RKinosaki/Odyssey/Drive/PCB/Odyssey_Driver.step

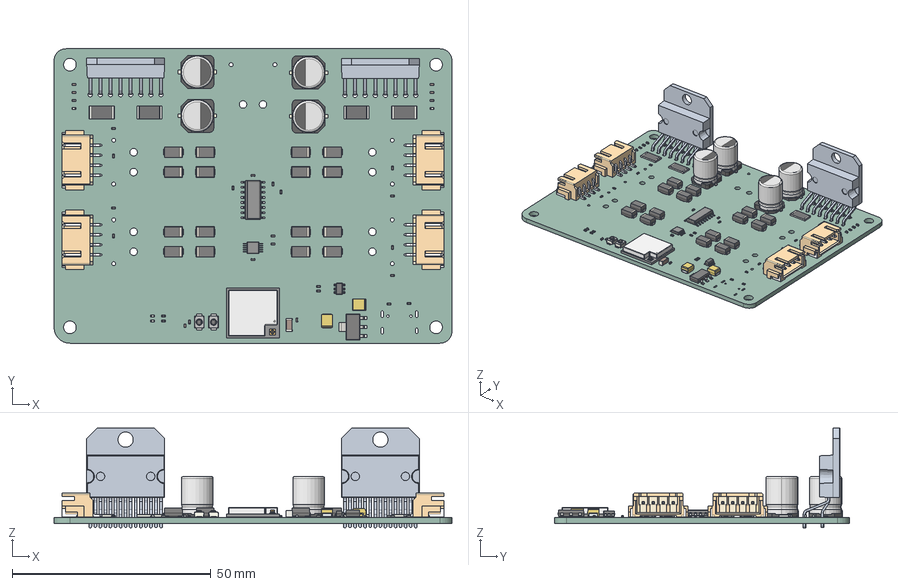
[picture p1: CAD file, 2026-05-25]
Drive/PCB/Odyssey_Driver.step
100.0 x 74.0 x 25.1 mm
R_0402_1005Metric x 22
D_SMA x 16
WSIZE CODE F-001 x 4
WSIZE CODE F-002 x 4
WSIZE CODE F-003 x 8
C_0402_1005Metric x 8
R_2512_6332Metric x 4
ESP32-C6-MINI-1U-N4
SOT-23-6
S4B-XH-SM4-TB_LF__SN_ x 4
LED_0402_1005Metric x 4
FilletPin1 x 2
FilletPin2 x 2
L298N x 2
SW_SPST_B3U-1000P x 2
C_1206_3216Metric
BODY-SO x 2
LEAD-SO x 26
PIN1-ID x 2
SOT-223
Odyssey_Driver_PCB
