RKinosaki/Odyssey/PowerDistribution/PCB/LabRover_PDB.kicad_pcb

## KiCad design PowerDistribution/PCB/LabRover_PDB.kicad_pcb (2026-07-19)

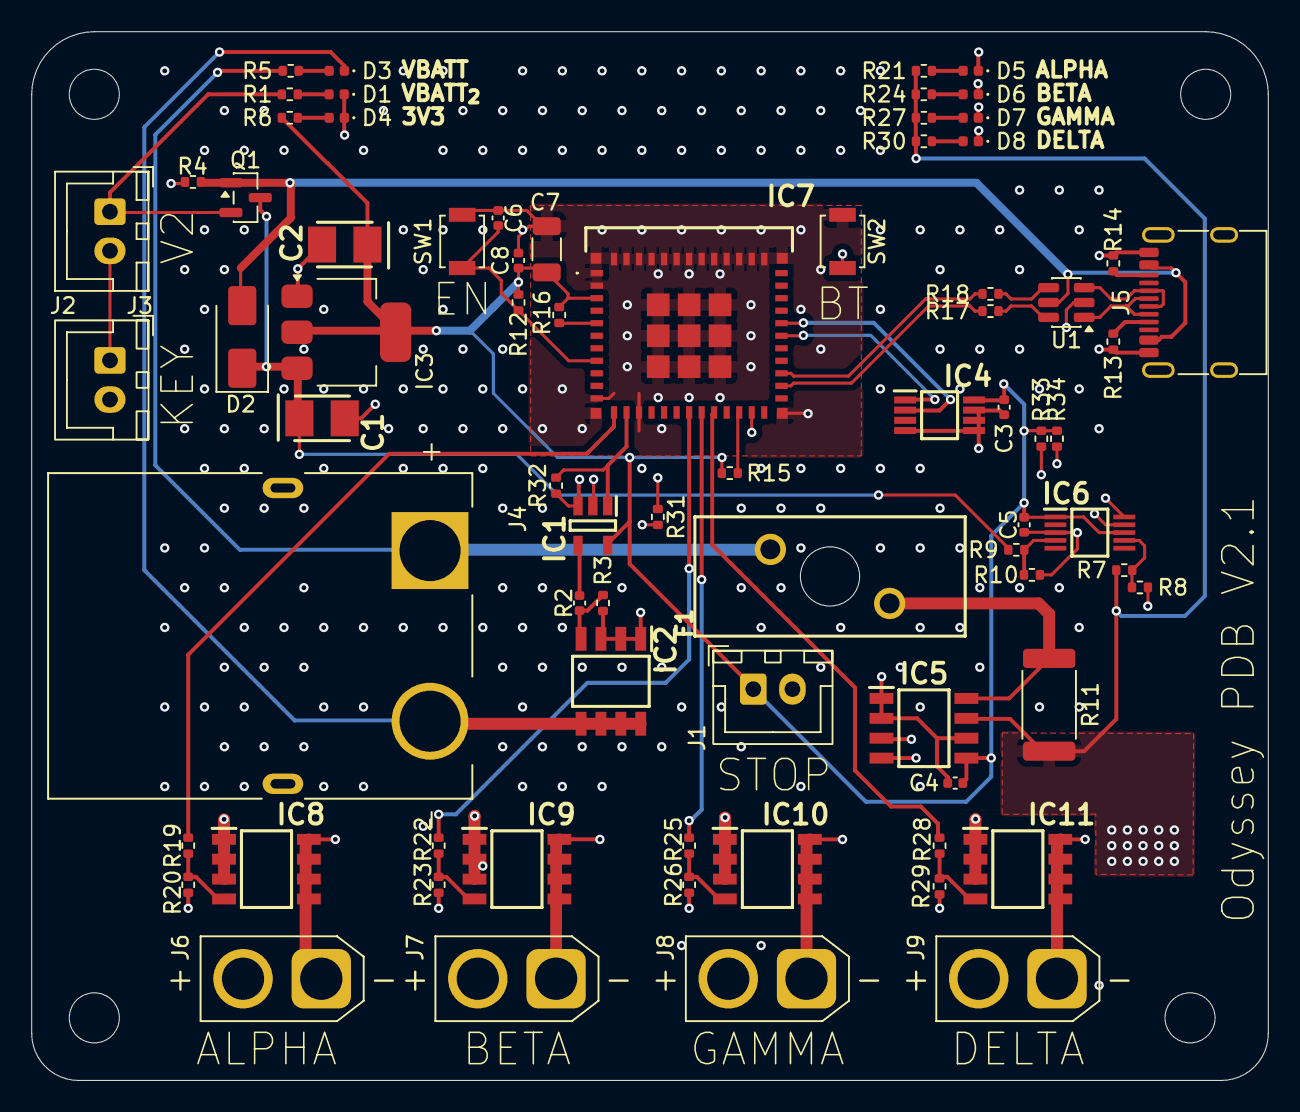
[picture p2: board LabRover_PDB.kicad_pcb from above]

Board: 4 copper layers, 79.0 x 67.0 mm, 75 parts (0 on the bottom side), 49 nets.

Parts:
C1, C2: TAJB226K020RNJ
C3, C4, C8: 100n; C_0402_1005Metric
C5, C6: 1u; C_0402_1005Metric
C7: 22u; C_1206_3216Metric
D1, D3, D4: GREEN; LED_0402_1005Metric
D2: SS12; D_SMA
D5, D6, D7, D8: BLUE; LED_0402_1005Metric
F1: 01530008Z; 01530008
IC1: SN74LVC1G08DBVR
IC2, IC8, IC9, IC10, IC11: SI4162DY-T1-GE3
IC3: TLV1117LV33DCYR; SOT-223-3_TabPin2
IC4: LM75BDP,118
IC5: INA219AIDR
IC6: ADS1015BQDGSRQ1
IC7: ESP32-C3-MINI-1U-N4X; ESP32C3MINI1UN4X
J1, J2, J3: Conn_01x02; JST_XH_B2B-XH-A_1x02_P2.50mm_Vertical
J4: Conn_01x02; AMASS_XT90PW-M
J5: USB_C_Receptacle_USB2.0_16P; USB_C_Receptacle_G-Switch_GT-USB-7010ASV
J6, J7, J8, J9: Conn_01x02; XT30
Q1: BSS84; SOT-23
R1: 1kR; R_0402_1005Metric
R2: 100; C_0402_1005Metric
R3, R10, R12, R15, R16, R20, R23, R26, R29, R31, R32, R33, R34: 10k; R_0402_1005Metric
R4: 10kR; R_0402_1005Metric
R5: 2.4k; R_0402_1005Metric
R6: 600; R_0402_1005Metric
R7: 560k; R_0402_1005Metric
R8: 100k; R_0402_1005Metric
R9: 5.1k; R_0402_1005Metric
R11: 0.01; R_2512_6332Metric
R13, R14: 5K1; R_0402_1005Metric
R17, R18: 22; R_0402_1005Metric
R19, R22, R25, R28: 100; R_0402_1005Metric
R21, R24, R27, R30: 470; R_0402_1005Metric
SW1, SW2: SW_Push; SW_SPST_B3U-1000P
U1: USBLC6-2SC6; SOT-23-6

Connections:
+3.3V: C2.1 (+), C3.1, C4.1, C5.1, C7.1, C8.1, IC1.5 (VCC), IC3.2 (OUTPUT_1), IC4.8 (VCC), IC5.5 (VS), IC6.1 (ADDR), IC6.8 (VDD), IC7.3 (3V3), J1.1, R6.2, R12.2, R15.1, R16.1, R33.1, R34.1
+BATT_SENSED: IC5.7 (IN-), J6.2, J7.2, J8.2, J9.2, R7.1, R11.2, R21.2, R24.2, R27.2, R30.2
+VBATT_{2}: J3.1, Q1.2 (S), R1.2
/ESP32_C3/5V: D2.2 (A), J5.A4 (VBUS), J5.A9 (VBUS), J5.B4 (VBUS), J5.B9 (VBUS), Q1.1 (G), R4.2, U1.5 (VBUS)
/ESP32_C3/BOOT: IC7.23 (IO9), SW2.1
/ESP32_C3/D+: R18.2, U1.4 (I/O2)
/ESP32_C3/D-: R17.2, U1.6 (I/O1)
/ESP32_C3/DR+: IC7.27 (IO19), R18.1
/ESP32_C3/DR-: IC7.26 (IO18), R17.1
/ESP32_C3/GPIO0: IC7.12 (IO0), R19.2
/ESP32_C3/GPIO1: IC1.1 (A), IC7.13 (IO1), R32.2
/ESP32_C3/GPIO2: IC7.5 (IO2), R16.2
/ESP32_C3/GPIO4: IC7.18 (IO4), R22.2
/ESP32_C3/GPIO5: IC7.19 (IO5), R25.2
/ESP32_C3/GPIO6: IC7.20 (IO6), R28.2
/ESP32_C3/GPIO8: IC7.22 (IO8), R15.2
/ESP32_C3/GPIO20: IC4.1 (SDA), IC5.3 (SDA), IC6.9 (SDA), IC7.30 (RXD0), R33.2
/ESP32_C3/GPIO21: IC4.2 (SCL), IC5.4 (SCL), IC6.10 (SCL), IC7.31 (TXD0), R34.2
/ESP32_C3/RST: C6.1, IC7.8 (EN), R12.1, SW1.1
/ESP32_C3/USB_D+: J5.A6 (D+), J5.B6 (D+), U1.3 (I/O2)
/ESP32_C3/USB_D-: J5.A7 (D-), J5.B7 (D-), U1.1 (I/O1)
/Power_Protection/VBATT_{2}Read: C1.1 (+), D2.1 (K), IC3.3 (INPUT), Q1.3 (D), R9.1
/Sensors/AIN0: IC6.4 (AIN0), R9.2, R10.1
/Sensors/AIN3: IC6.7 (AIN3), R7.2, R8.1
/Sensors/IN+: F1.2, IC5.8 (IN+), R11.1
GND: C1.2 (-), C2.2 (-), C3.2, C4.2, C5.2, C6.2, C7.2, C8.2, D1.1 (K), D4.1 (K), IC1.3 (GND), IC2.1 (S_1), IC2.2 (S_2), IC2.3 (S_3), IC3.1 (GND), IC4.4 (GND), IC4.5 (A2), IC4.6 (A1), IC4.7 (A0), IC5.1 (A1), IC5.2 (A0), IC5.6 (GND), IC6.3 (GND), IC7.1 (GND_1), IC7.2 (GND_2), IC7.11 (GND_3), IC7.14 (GND_4), IC7.36 (GND_5), IC7.37 (GND_6), IC7.38 (GND_7), IC7.39 (GND_8), IC7.40 (GND_9), IC7.41 (GND_10), IC7.42 (GND_11), IC7.43 (GND_12), IC7.44 (GND_13), IC7.45 (GND_14), IC7.46 (GND_15), IC7.47 (GND_16), IC7.48 (GND_17), IC7.49 (GND_18), IC7.50 (GND_19), IC7.51 (GND_20), IC7.52 (GND_21), IC7.53 (GND_22), IC7.54 (GND_23), IC7.55 (GND_24), IC7.56 (GND_25), IC7.57 (GND_26), IC7.58 (GND_27), IC7.59 (GND_28), IC7.60 (GND_29), IC7.61 (GND_30), IC8.1 (S_1), IC8.2 (S_2), IC8.3 (S_3), IC9.1 (S_1), IC9.2 (S_2), IC9.3 (S_3), IC10.1 (S_1), IC10.2 (S_2), IC10.3 (S_3), IC11.1 (S_1), IC11.2 (S_2), IC11.3 (S_3), J2.2, J5.A1 (GND), J5.A12 (GND), J5.B1 (GND), J5.B12 (GND), R3.1, R4.1, R8.2, R10.2, R13.2, R14.1, R20.1, R23.1, R26.1, R29.1, R31.1, R32.1, SW1.2, SW2.2, U1.2 (GND)
unnamed: D1.2 (A), R1.1
unnamed: D3.2 (A), R5.1
unnamed: D3.1 (K), IC2.5 (D_1), IC2.6 (D_2), IC2.7 (D_3), IC2.8 (D_4)
unnamed: D4.2 (A), R6.1
unnamed: D5.2 (A), R21.1
unnamed: D5.1 (K), IC8.5 (D_1), IC8.6 (D_2), IC8.7 (D_3), IC8.8 (D_4), J6.1
unnamed: D6.2 (A), R24.1
unnamed: D6.1 (K), IC9.5 (D_1), IC9.6 (D_2), IC9.7 (D_3), IC9.8 (D_4), J7.1
unnamed: D7.2 (A), R27.1
unnamed: D7.1 (K), IC10.5 (D_1), IC10.6 (D_2), IC10.7 (D_3), IC10.8 (D_4), J8.1
unnamed: D8.2 (A), R30.1
unnamed: D8.1 (K), IC11.5 (D_1), IC11.6 (D_2), IC11.7 (D_3), IC11.8 (D_4), J9.1
unnamed: IC1.2 (B), J1.2, R31.2
unnamed: IC1.4 (Y), R2.1
unnamed: IC2.4 (G), R2.2, R3.2
unnamed: IC8.4 (G), R19.1, R20.2
unnamed: IC9.4 (G), R22.1, R23.2
unnamed: IC10.4 (G), R25.1, R26.2
unnamed: IC11.4 (G), R28.1, R29.2
unnamed: J2.1, J3.2
unnamed: F1.1, R5.2
unnamed: J5.A5 (CC1), R13.1
unnamed: J5.B5 (CC2), R14.2
