RKinosaki/Odyssey/Drive/PCB/Odyssey_Driver.kicad_pcb

## KiCad design Drive/PCB/Odyssey_Driver.kicad_pcb (2026-05-03)

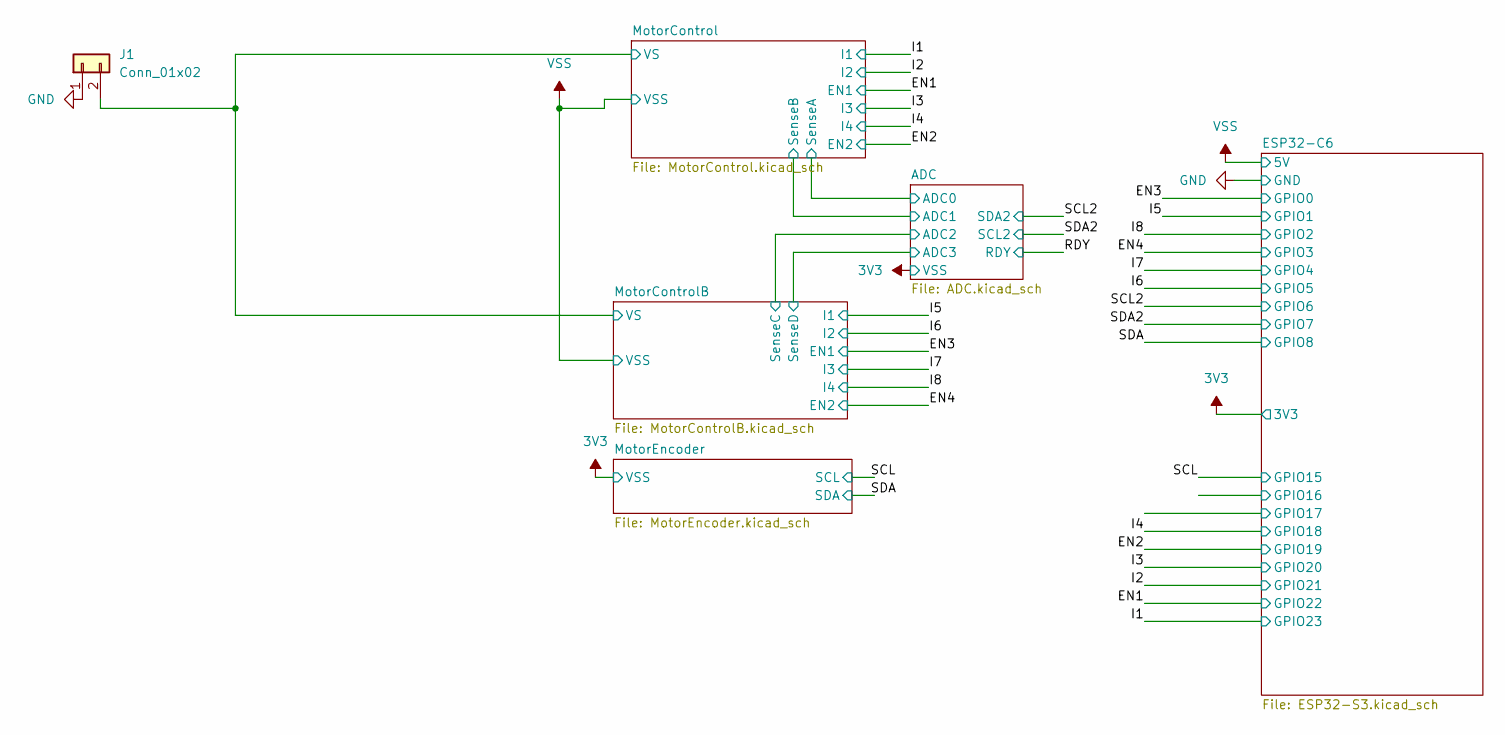
[picture p3: schematic Odyssey_Driver.kicad_sch]

Parts:
J1: Conn_01x02; AMASS_XT30PW-M_1x02_P2.50mm_Horizontal

Connections:
/MotorControl/VS: J1.2; also elsewhere on the board
GND: J1.1; also elsewhere on the board

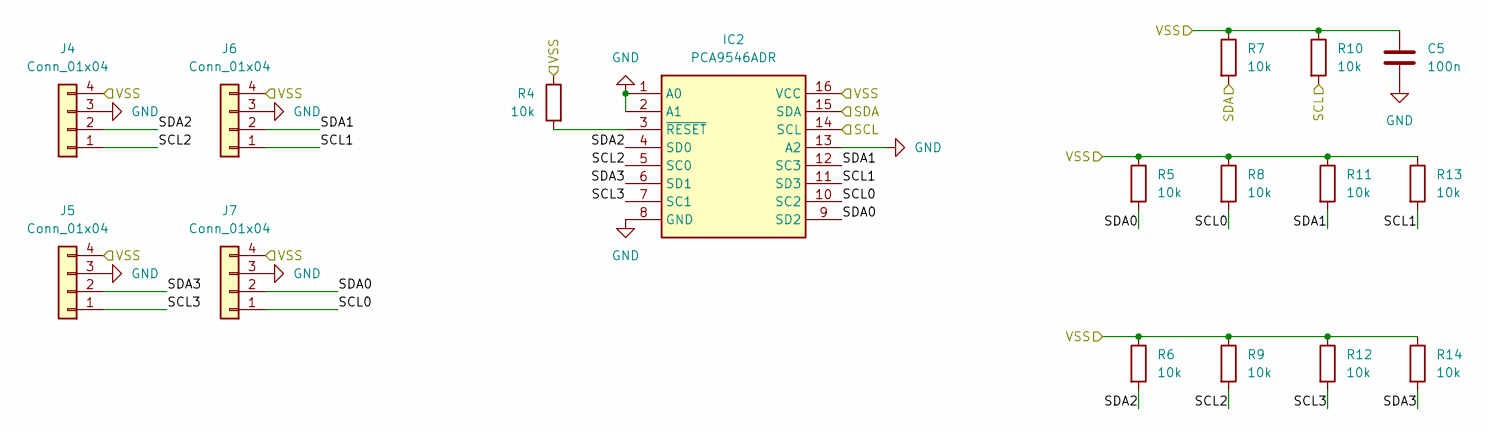
[picture p4: schematic MotorEncoder.kicad_sch]

Parts:
C5: 100n; C_0402_1005Metric
IC2: PCA9546ADR; SOIC127P600X175-16N; Mouser Part Number 595-PCA9546ADR
J4, J5, J6, J7: Conn_01x04; S4BXHSM4TBLFSN
R4, R5, R6, R7, R8, R9, R10, R11, R12, R13, R14: 10k; R_0402_1005Metric

Connections:
3V3: C5.1, IC2.16 (VCC), J4.4, J5.4, J6.4, J7.4, R4.1, R5.1, R6.1, R7.1, R8.1, R9.1, R10.1, R11.1, R12.1, R13.1, R14.1; also elsewhere on the board
/MotorEncoder/SCL0: IC2.10 (SC2), J7.1, R8.2
/MotorEncoder/SCL1: IC2.11 (SD3), J6.1, R13.2
/MotorEncoder/SCL2: IC2.5 (SC0), J4.1, R9.2
/MotorEncoder/SCL3: IC2.7 (SC1), J5.1, R12.2
/MotorEncoder/SDA0: IC2.9 (SD2), J7.2, R5.2
/MotorEncoder/SDA1: IC2.12 (SC3), J6.2, R11.2
/MotorEncoder/SDA2: IC2.4 (SD0), J4.2, R6.2
/MotorEncoder/SDA3: IC2.6 (SD1), J5.2, R14.2
/SCL: IC2.14 (SCL), R10.2; also elsewhere on the board
/SDA: IC2.15 (SDA), R7.2; also elsewhere on the board
GND: C5.2, IC2.1 (A0), IC2.2 (A1), IC2.8 (GND), IC2.13 (A2), J4.3, J5.3, J6.3, J7.3; also elsewhere on the board
unnamed: IC2.3 (~RESET), R4.2

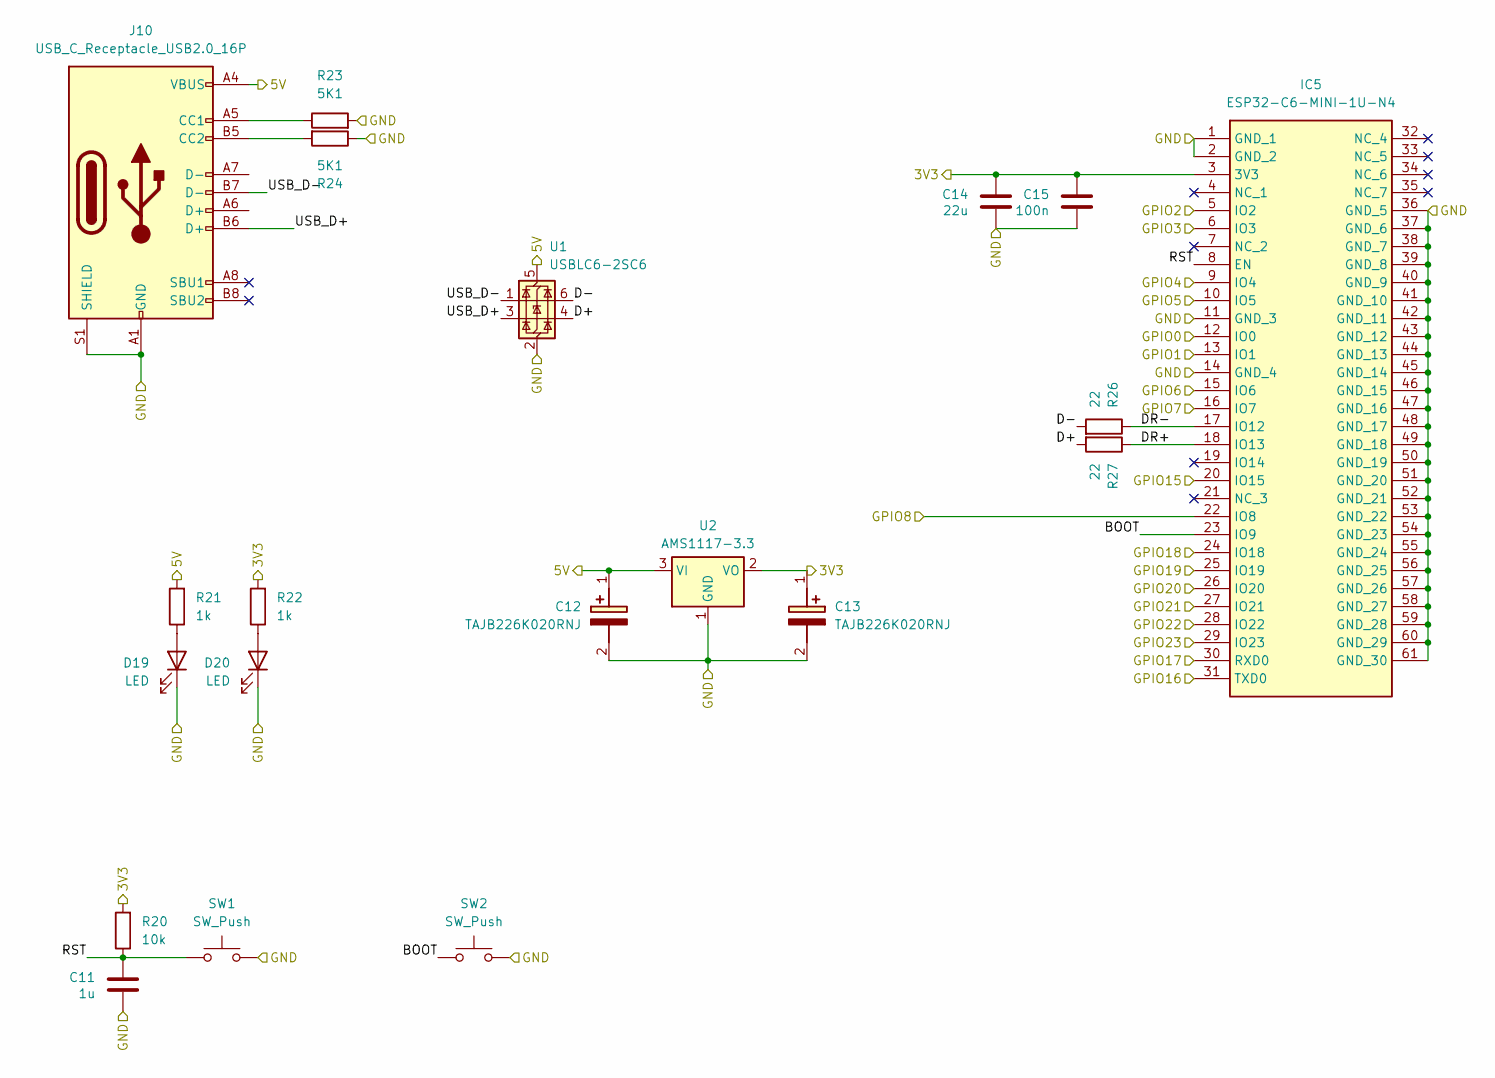
[picture p5: schematic ESP32-S3.kicad_sch]

Parts:
C11: 1u; C_0402_1005Metric
C12, C13: TAJB226K020RNJ; CAPPM3528X210N; Mouser Part Number 581-TAJB226K020R
C14: 22u; C_1206_3216Metric
C15: 100n; C_0402_1005Metric
D19, D20: LED; LED_0402_1005Metric
IC5: ESP32-C6-MINI-1U-N4; ESP32C6MINI1UN4; Mouser Part Number 356-ESP32-C6MINI1UN4
J10: USB_C_Receptacle_USB2.0_16P; USB_C_Receptacle_G-Switch_GT-USB-7010ASV
R20: 10k; R_0402_1005Metric
R21, R22: 1k; R_0402_1005Metric
R23, R24: 5K1; R_0402_1005Metric
R26, R27: 22; R_0402_1005Metric
SW1, SW2: SW_Push; SW_SPST_B3U-1000P
U1: USBLC6-2SC6; SOT-23-6
U2: AMS1117-3.3; SOT-223-3_TabPin2

Connections:
3V3: C13.1 (+), C14.1, C15.1, IC5.3 (3V3), R20.2, R22.2, U2.2 (VO); also elsewhere on the board
/EN1: IC5.28 (IO22); also elsewhere on the board
/EN2: IC5.25 (IO19); also elsewhere on the board
/EN3: IC5.12 (IO0); also elsewhere on the board
/EN4: IC5.6 (IO3); also elsewhere on the board
/ESP32-C6/BOOT: IC5.23 (IO9), SW2.1
/ESP32-C6/D+: R27.2, U1.4 (I/O2)
/ESP32-C6/D-: R26.2, U1.6 (I/O1)
/ESP32-C6/DR+: IC5.18 (IO13), R27.1
/ESP32-C6/DR-: IC5.17 (IO12), R26.1
/ESP32-C6/GPIO16: IC5.31 (TXD0)
/ESP32-C6/GPIO17: IC5.30 (RXD0)
/ESP32-C6/RST: C11.1, IC5.8 (EN), R20.1, SW1.1
/ESP32-C6/USB_D+: J10.B6 (D+), U1.3 (I/O2)
/ESP32-C6/USB_D-: J10.B7 (D-), U1.1 (I/O1)
/I1: IC5.29 (IO23); also elsewhere on the board
/I2: IC5.27 (IO21); also elsewhere on the board
/I3: IC5.26 (IO20); also elsewhere on the board
/I4: IC5.24 (IO18); also elsewhere on the board
/I5: IC5.13 (IO1); also elsewhere on the board
/I6: IC5.10 (IO5); also elsewhere on the board
/I7: IC5.9 (IO4); also elsewhere on the board
/I8: IC5.5 (IO2); also elsewhere on the board
/SCL: IC5.20 (IO15); also elsewhere on the board
/SCL2: IC5.15 (IO6); also elsewhere on the board
/SDA: IC5.22 (IO8); also elsewhere on the board
/SDA2: IC5.16 (IO7); also elsewhere on the board
GND: C11.2, C12.2 (-), C13.2 (-), C14.2, C15.2, D19.1 (K), D20.1 (K), IC5.1 (GND_1), IC5.2 (GND_2), IC5.11 (GND_3), IC5.14 (GND_4), IC5.36 (GND_5), IC5.37 (GND_6), IC5.38 (GND_7), IC5.39 (GND_8), IC5.40 (GND_9), IC5.41 (GND_10), IC5.42 (GND_11), IC5.43 (GND_12), IC5.44 (GND_13), IC5.45 (GND_14), IC5.46 (GND_15), IC5.47 (GND_16), IC5.48 (GND_17), IC5.49 (GND_18), IC5.50 (GND_19), IC5.51 (GND_20), IC5.52 (GND_21), IC5.53 (GND_22), IC5.54 (GND_23), IC5.55 (GND_24), IC5.56 (GND_25), IC5.57 (GND_26), IC5.58 (GND_27), IC5.59 (GND_28), IC5.60 (GND_29), IC5.61 (GND_30), J10.A1 (GND), J10.A12 (GND), J10.B1 (GND), J10.B12 (GND), J10.S1 (SHIELD), R23.2, R24.1, SW1.2, SW2.2, U1.2 (GND), U2.1 (GND); also elsewhere on the board
unnamed: D19.2 (A), R21.1
unnamed: D20.2 (A), R22.1
unnamed: J10.A5 (CC1), R23.1
unnamed: J10.B5 (CC2), R24.2
VSS: C12.1 (+), J10.A4 (VBUS), J10.A9 (VBUS), J10.B4 (VBUS), J10.B9 (VBUS), R21.2, U1.5 (VBUS), U2.3 (VI); also elsewhere on the board

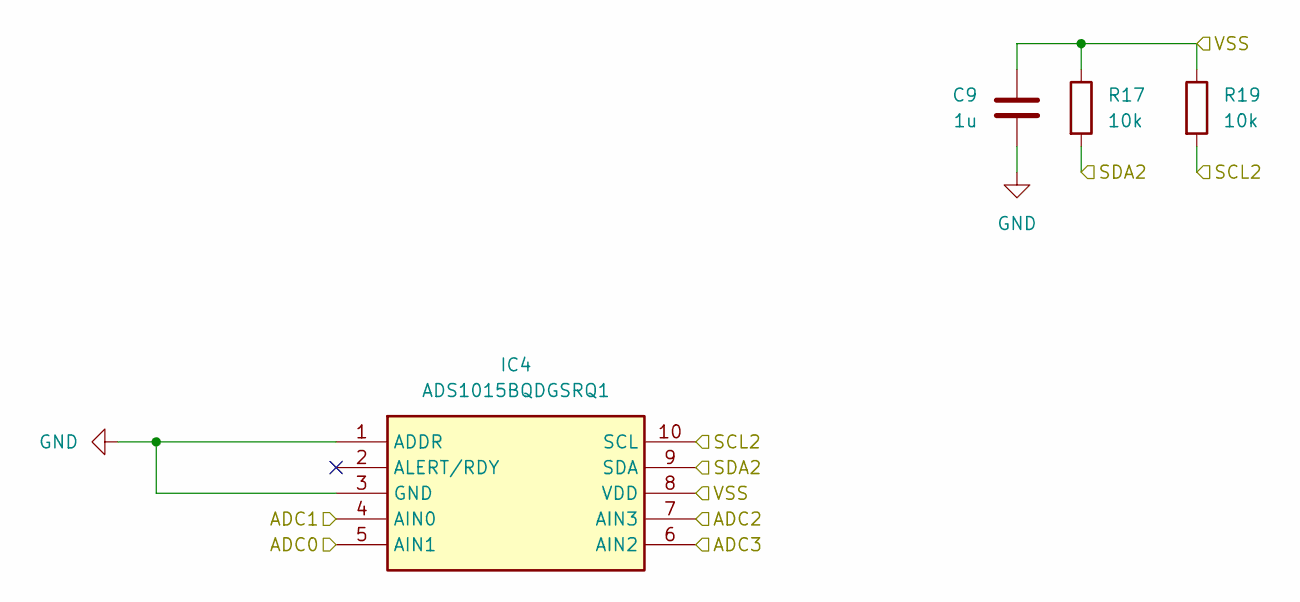
[picture p6: schematic ADC.kicad_sch]

Parts:
C9: 1u; C_0402_1005Metric
IC4: ADS1015BQDGSRQ1; SOP50P490X110-10N; Mouser Part Number 595-ADS1015BQDGSRQ1
R17, R19: 10k; R_0402_1005Metric

Connections:
3V3: C9.1, IC4.8 (VDD), R17.1, R19.1; also elsewhere on the board
/ADC/ADC0: IC4.5 (AIN1); also elsewhere on the board
/ADC/ADC1: IC4.4 (AIN0); also elsewhere on the board
/ADC/ADC2: IC4.7 (AIN3); also elsewhere on the board
/ADC/ADC3: IC4.6 (AIN2); also elsewhere on the board
/SCL2: IC4.9 (SDA), R17.2; also elsewhere on the board
/SDA2: IC4.10 (SCL), R19.2; also elsewhere on the board
GND: C9.2, IC4.1 (ADDR), IC4.3 (GND); also elsewhere on the board

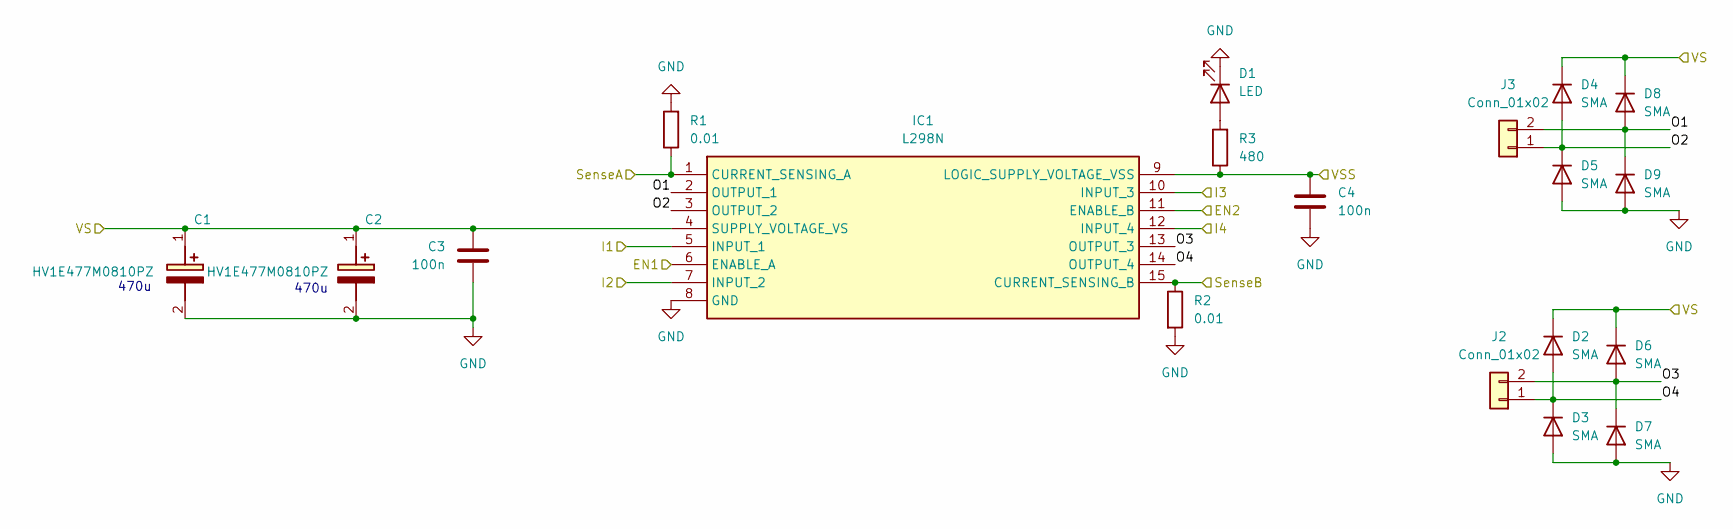
[picture p7: schematic MotorControl.kicad_sch]

Parts:
C1, C2: HV1E477M0810PZ; EEHZT1E331UP; Mouser Part Number 667-EEE-FT1E471GP
C3, C4: 100n; C_0402_1005Metric
D1: LED; LED_0402_1005Metric
D2, D3, D4, D5, D6, D7, D8, D9: SMA; D_SMA
IC1: L298N; TO127P500X2020X2210-15P; Mouser Part Number 511-L298
J2, J3: Conn_01x02; AMASS_XT30PW-F_1x02_P2.50mm_Horizontal
R1, R2: 0.01; R_2512_6332Metric
R3: 480; R_0402_1005Metric

Connections:
/ADC/ADC0: IC1.1 (CURRENT_SENSING_A), R1.1; also elsewhere on the board
/ADC/ADC1: IC1.15 (CURRENT_SENSING_B), R2.1; also elsewhere on the board
/EN1: IC1.6 (ENABLE_A); also elsewhere on the board
/EN2: IC1.11 (ENABLE_B); also elsewhere on the board
/I1: IC1.5 (INPUT_1); also elsewhere on the board
/I2: IC1.7 (INPUT_2); also elsewhere on the board
/I3: IC1.10 (INPUT_3); also elsewhere on the board
/I4: IC1.12 (INPUT_4); also elsewhere on the board
/MotorControl/O1: D8.2 (A), D9.1 (K), IC1.2 (OUTPUT_1), J3.2
/MotorControl/O2: D4.2 (A), D5.1 (K), IC1.3 (OUTPUT_2), J3.1
/MotorControl/O3: D6.2 (A), D7.1 (K), IC1.13 (OUTPUT_3), J2.2
/MotorControl/O4: D2.2 (A), D3.1 (K), IC1.14 (OUTPUT_4), J2.1
/MotorControl/VS: C1.1 (+), C2.1 (+), C3.1, D2.1 (K), D4.1 (K), D6.1 (K), D8.1 (K), IC1.4 (SUPPLY_VOLTAGE_VS); also elsewhere on the board
GND: C1.2 (-), C2.2 (-), C3.2, C4.2, D1.1 (K), D3.2 (A), D5.2 (A), D7.2 (A), D9.2 (A), IC1.8 (GND), R1.2, R2.2; also elsewhere on the board
unnamed: D1.2 (A), R3.2
VSS: C4.1, IC1.9 (LOGIC_SUPPLY_VOLTAGE_VSS), R3.1; also elsewhere on the board

Notes on the sheet:
470u

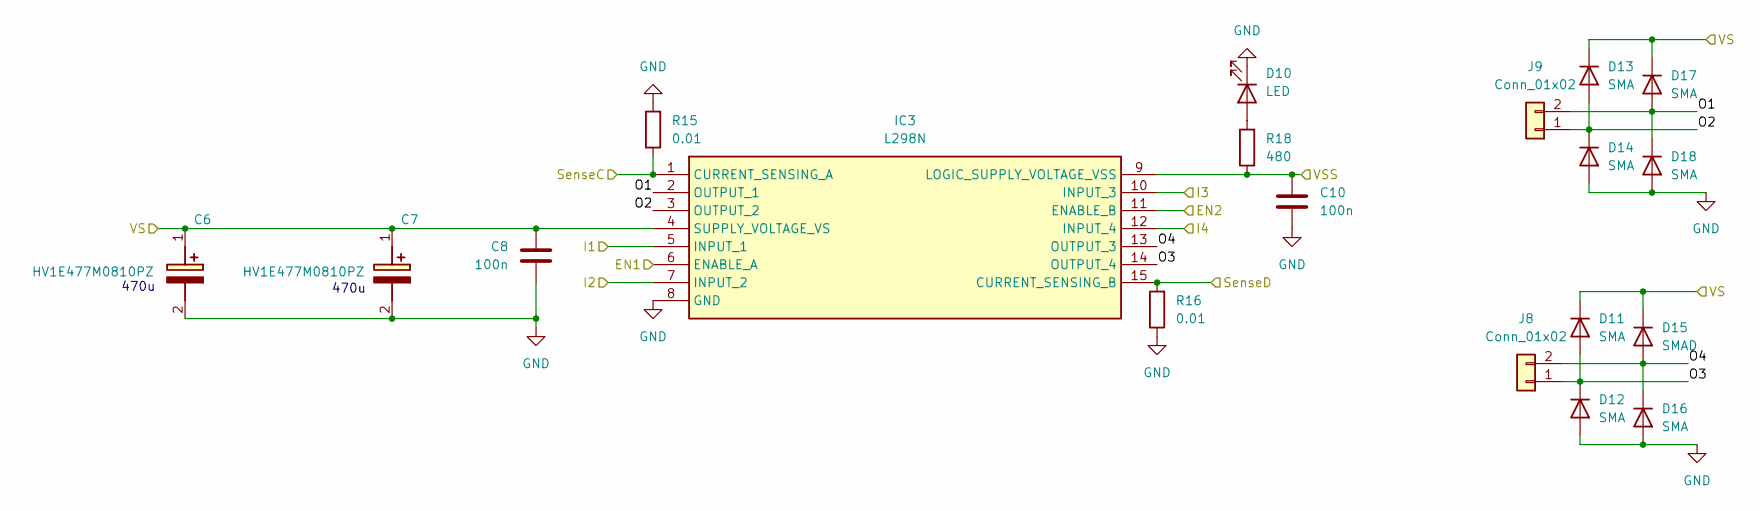
[picture p8: schematic MotorControlB.kicad_sch]

Parts:
C6, C7: HV1E477M0810PZ; EEHZT1E331UP; Mouser Part Number 667-EEE-FT1E471GP
C8, C10: 100n; C_0402_1005Metric
D10: LED; LED_0402_1005Metric
D11, D12, D13, D14, D16, D17, D18: SMA; D_SMA
D15: SMAD; D_SMA
IC3: L298N; TO127P500X2020X2210-15P; Mouser Part Number 511-L298
J8, J9: Conn_01x02; AMASS_XT30PW-F_1x02_P2.50mm_Horizontal
R15, R16: 0.01; R_2512_6332Metric
R18: 480; R_0402_1005Metric

Connections:
/ADC/ADC2: IC3.1 (CURRENT_SENSING_A), R15.1; also elsewhere on the board
/ADC/ADC3: IC3.15 (CURRENT_SENSING_B), R16.2; also elsewhere on the board
/EN3: IC3.6 (ENABLE_A); also elsewhere on the board
/EN4: IC3.11 (ENABLE_B); also elsewhere on the board
/I5: IC3.5 (INPUT_1); also elsewhere on the board
/I6: IC3.7 (INPUT_2); also elsewhere on the board
/I7: IC3.10 (INPUT_3); also elsewhere on the board
/I8: IC3.12 (INPUT_4); also elsewhere on the board
/MotorControl/VS: C6.1 (+), C7.1 (+), C8.1, D11.1 (K), D13.1 (K), D15.1 (K), D17.1 (K), IC3.4 (SUPPLY_VOLTAGE_VS); also elsewhere on the board
/MotorControlB/O1: D17.2 (A), D18.1 (K), IC3.2 (OUTPUT_1), J9.2
/MotorControlB/O2: D13.2 (A), D14.1 (K), IC3.3 (OUTPUT_2), J9.1
/MotorControlB/O3: D11.2 (A), D12.1 (K), IC3.14 (OUTPUT_4), J8.1
/MotorControlB/O4: D15.2 (A), D16.1 (K), IC3.13 (OUTPUT_3), J8.2
GND: C6.2 (-), C7.2 (-), C8.2, C10.2, D10.1 (K), D12.2 (A), D14.2 (A), D16.2 (A), D18.2 (A), IC3.8 (GND), R15.2, R16.1; also elsewhere on the board
unnamed: D10.2 (A), R18.2
VSS: C10.1, IC3.9 (LOGIC_SUPPLY_VOLTAGE_VSS), R18.1; also elsewhere on the board

Notes on the sheet:
470u

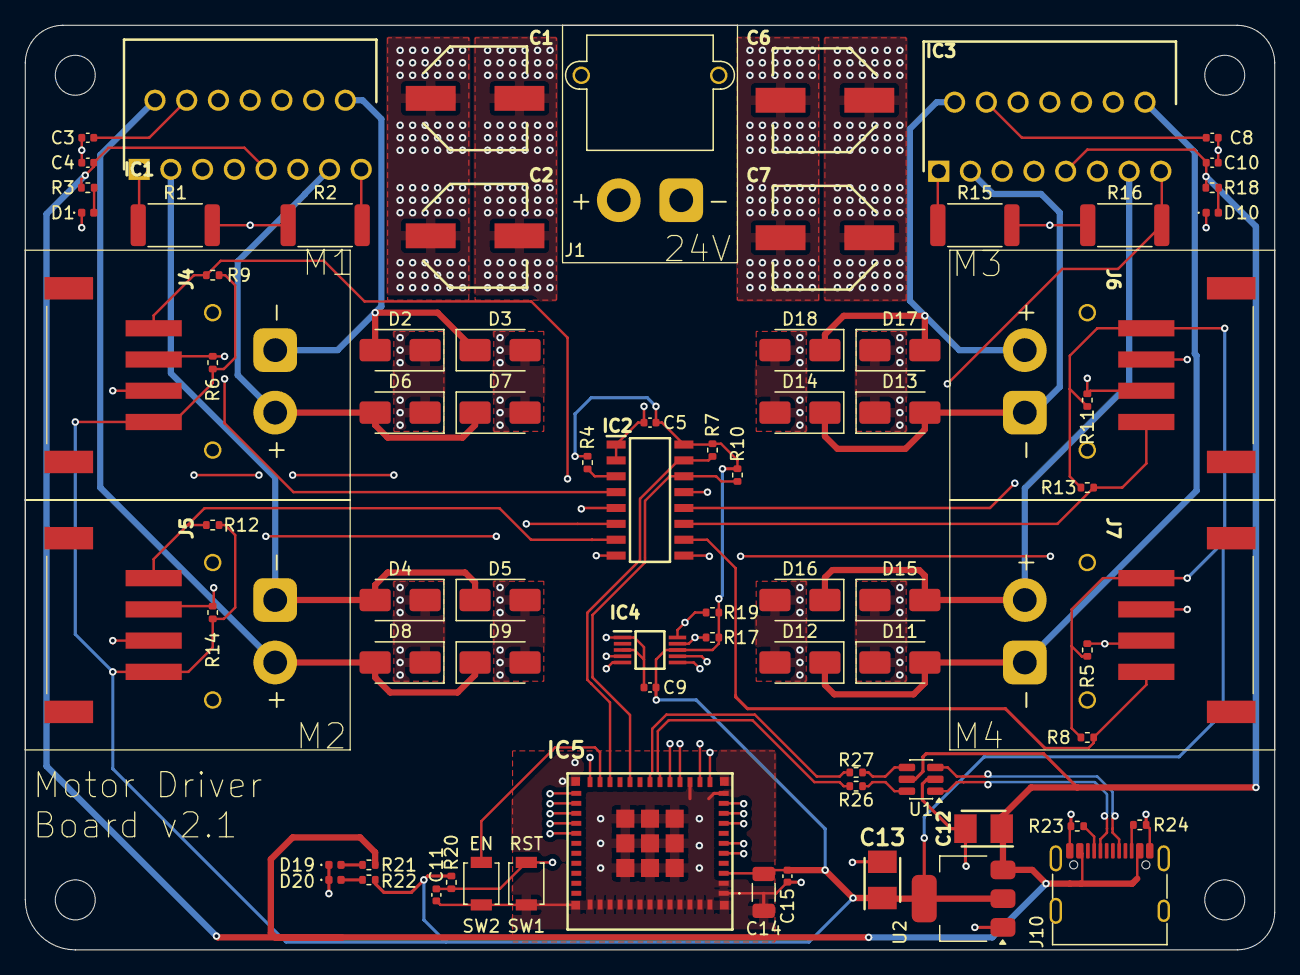
[picture p9: board Odyssey_Driver.kicad_pcb from above]

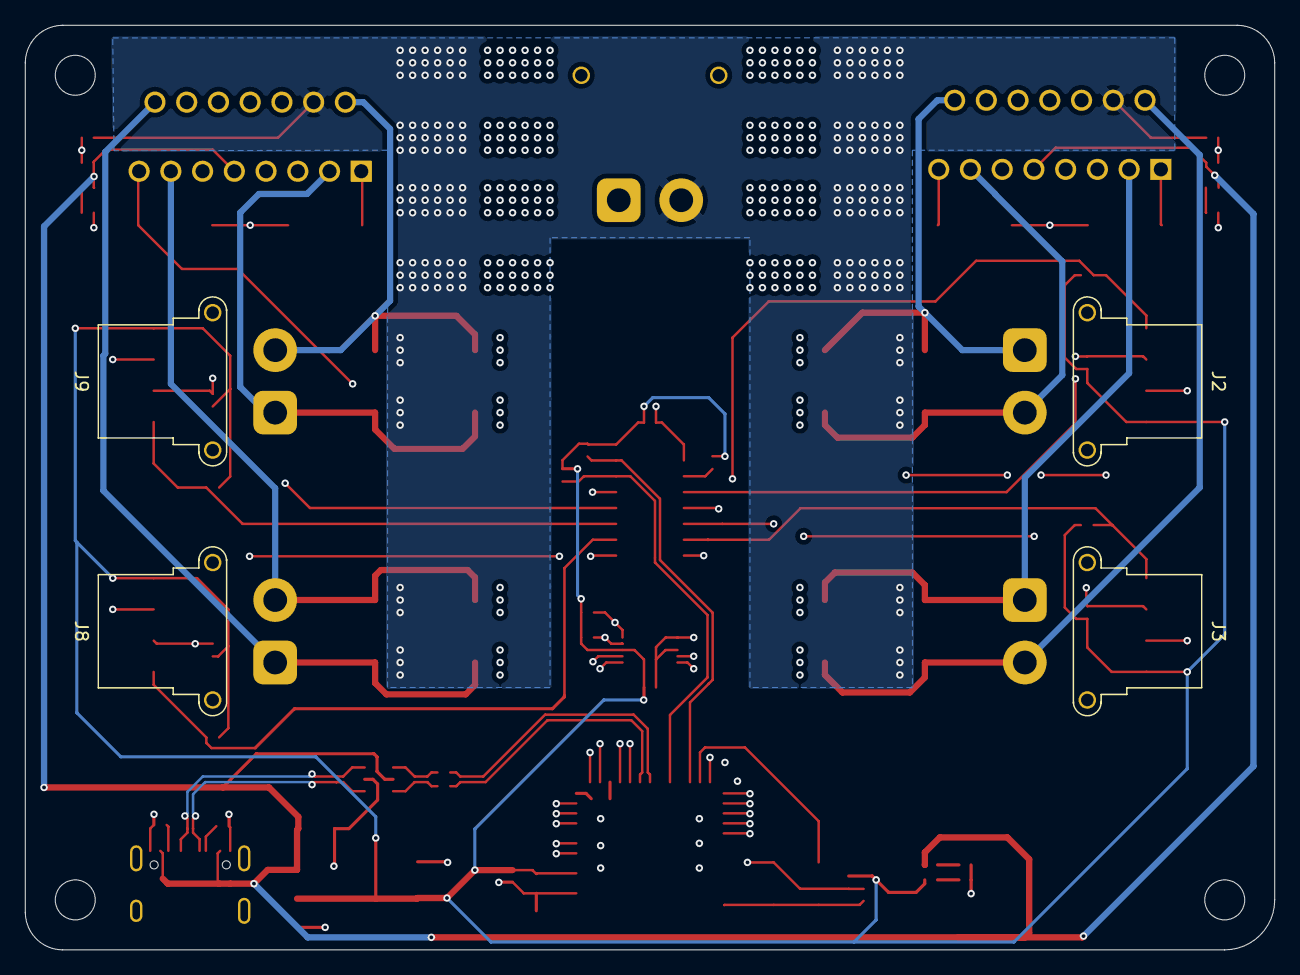
[picture p10: board Odyssey_Driver.kicad_pcb from below]

Board: 4 copper layers, 100.0 x 74.0 mm, 80 parts (4 on the bottom side), 55 nets.
