RKinosaki/Odyssey/PowerDistribution/Firmware/src/config.h

#ifndef CONFIG_H
#define CONFIG_H
#include <Arduino.h>

//FET PINS
#define FET_MAIN 1
#define FET_ALPHA 0
#define FET_BETA 4
#define FET_GAMMA 5
#define FET_DELTA 6

//I2C
#define SCL 11
#define SDA 12

//I2C Address
#define ADS_ADDR 0x49
#define INA_ADDR 0x40
#define LNA_ADDR 0X48

//IN219
#define FILTER_SAMPLE_SIZE  5

//ADC
#define ADC_PD_RATIO 0.15151515
#define ADC_PD_RATIO_2 0.662252

#endif
