RKinosaki/Odyssey/(commit log)

2026-05-02 Adds V2.1 Driver Files
    [ESP32-S3.kicad_sch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]
2026-05-03 Adds PDB v2.0
    [LabRover_PDB-B_Cu.gbl, LabRover_PDB-B_Mask.gbs, LabRover_PDB-B_Paste.gbp, LabRover_PDB-B_Silkscreen.gbo, LabRover_PDB-Edge_Cuts.gm1, LabRover_PDB-F_Cu.gtl, LabRover_PDB-F_Mask.gts, LabRover_PDB-F_Paste.gtp]
2026-05-25 Remapped to v2.1
    [Odyssey_Driver.kicad_sch, Odyssey_Driver.step]
2026-07-18 Firmware for v2.0, and hardware fixes change for v2.1
    [LabRover_PDB.kicad_pcb, Power_Protection.kicad_sch, Sensors.kicad_sch]
2026-07-19 Gitignore fix
    [Backuo.kicad_sch, LabRover_PDB.kicad_pcb, POWER_OUT.kicad_sch, Power_Protection.kicad_sch, Sensors.kicad_sch, uC.kicad_sch]
